plan44/ledcontroller-hardware/(notices)

Notices in the files:
controller/ledcontroller.sch:
© 2018 by luz/plan44.ch
